Ryz3D/SPEAR/step2/spear74.pdf

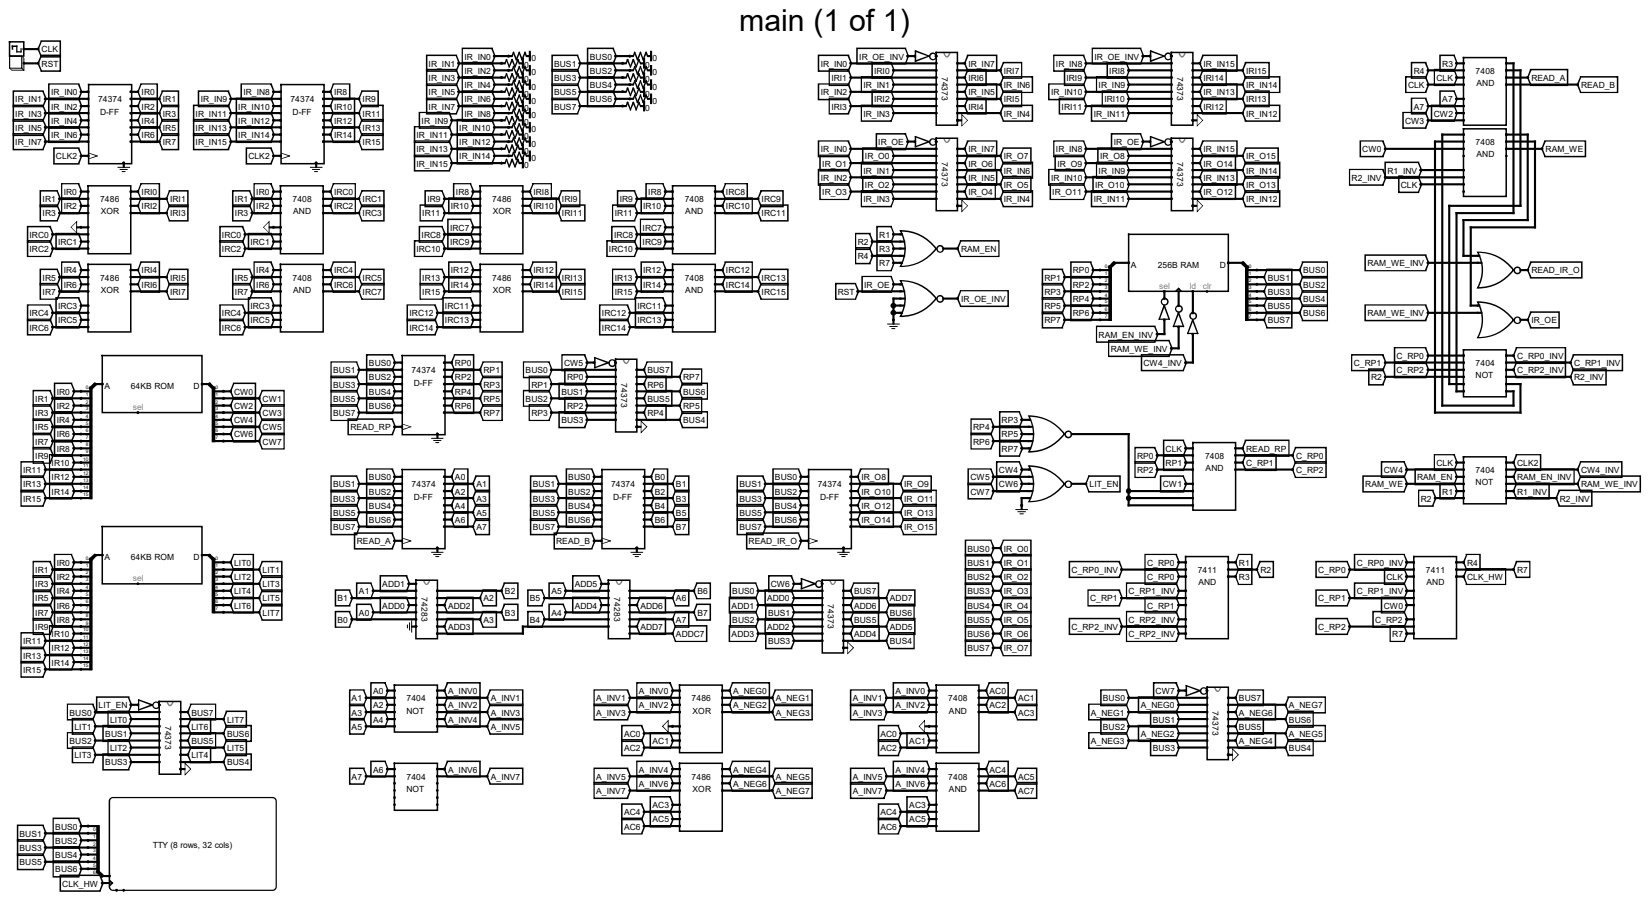
[picture p2: page 1]
main (1 of 1); LIT_EN IR1; R1 LIT6; IR_O2 XOR 7486; BUS5 IR_IN14; BUS7; BUS0 IRI9; IRI14 IR0; 256B RAM; D sel; ld clr; AND 7411 IR5; A_INV0 CW1 IR_IN12 BUS0 IR7; 0 BUS5 7408 AND; A_NEG0 IR11 LIT4; IRI0AC2 BUS3; IR15 BUS3; 74373 BUS4 CW2 IR_IN10 CW7 A7 CW2 IRC0; R1 IR_IN12 CW6 A_INV2 LIT7; BUS1; IR_O14 RP2 A_INV6; XOR 7486; RAM_EN; CLK2 IR_IN1 IR5; A_NEG4 IR11; IRC3; IR14 BUS6 IR4; BUS4; IRC1; RP1 IRI8 BUS5 IRC14; R2_INV AC0; RP6 7408 AND; A_NEG2 IR_O5 IR13; RP2 BUS2; BUS6 LIT1; RAM_EN_INV BUS3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

74373 IRC4 A7A2 IRC4 IRC6 IR_IN13 LIT1 IRC5 AC5 RP3 XOR RP3 7486 IR_O10 IRC8 IR7 7408 AND IR_O0 IR4 IRC7 IRI10 RP5 B2 RP1 IR15 BUS1 RAM_WE IR_O1 BUS6 CW4_INV BUS6 IR_IN11 RAM_EN C_RP0 IR_IN2 IR_OE IR_IN1 7408 AND A7 IR_IN10 IRI11 LIT0 IR_IN15 READ_RP IRC11 IR_IN11 IRI4 RAM_EN_INV IR_O12 IR6

74373 A2 BUS2 IRI15 D-FF 74374 IRC10 R3 R2_INV NOT 7404 BUS0 IRI8 C_RP2_INV 7408 AND IRC11 BUS7 IRI15 AC7

74373 IR10 IR_IN9 IR_IN13 CLK IR3 CLK IR15 IR_O9 IRC9 TTY (8 rows, 32 cols) R7 A_INV3 IR3
