Ryz3D/SPEAR/step3/schematic.pdf

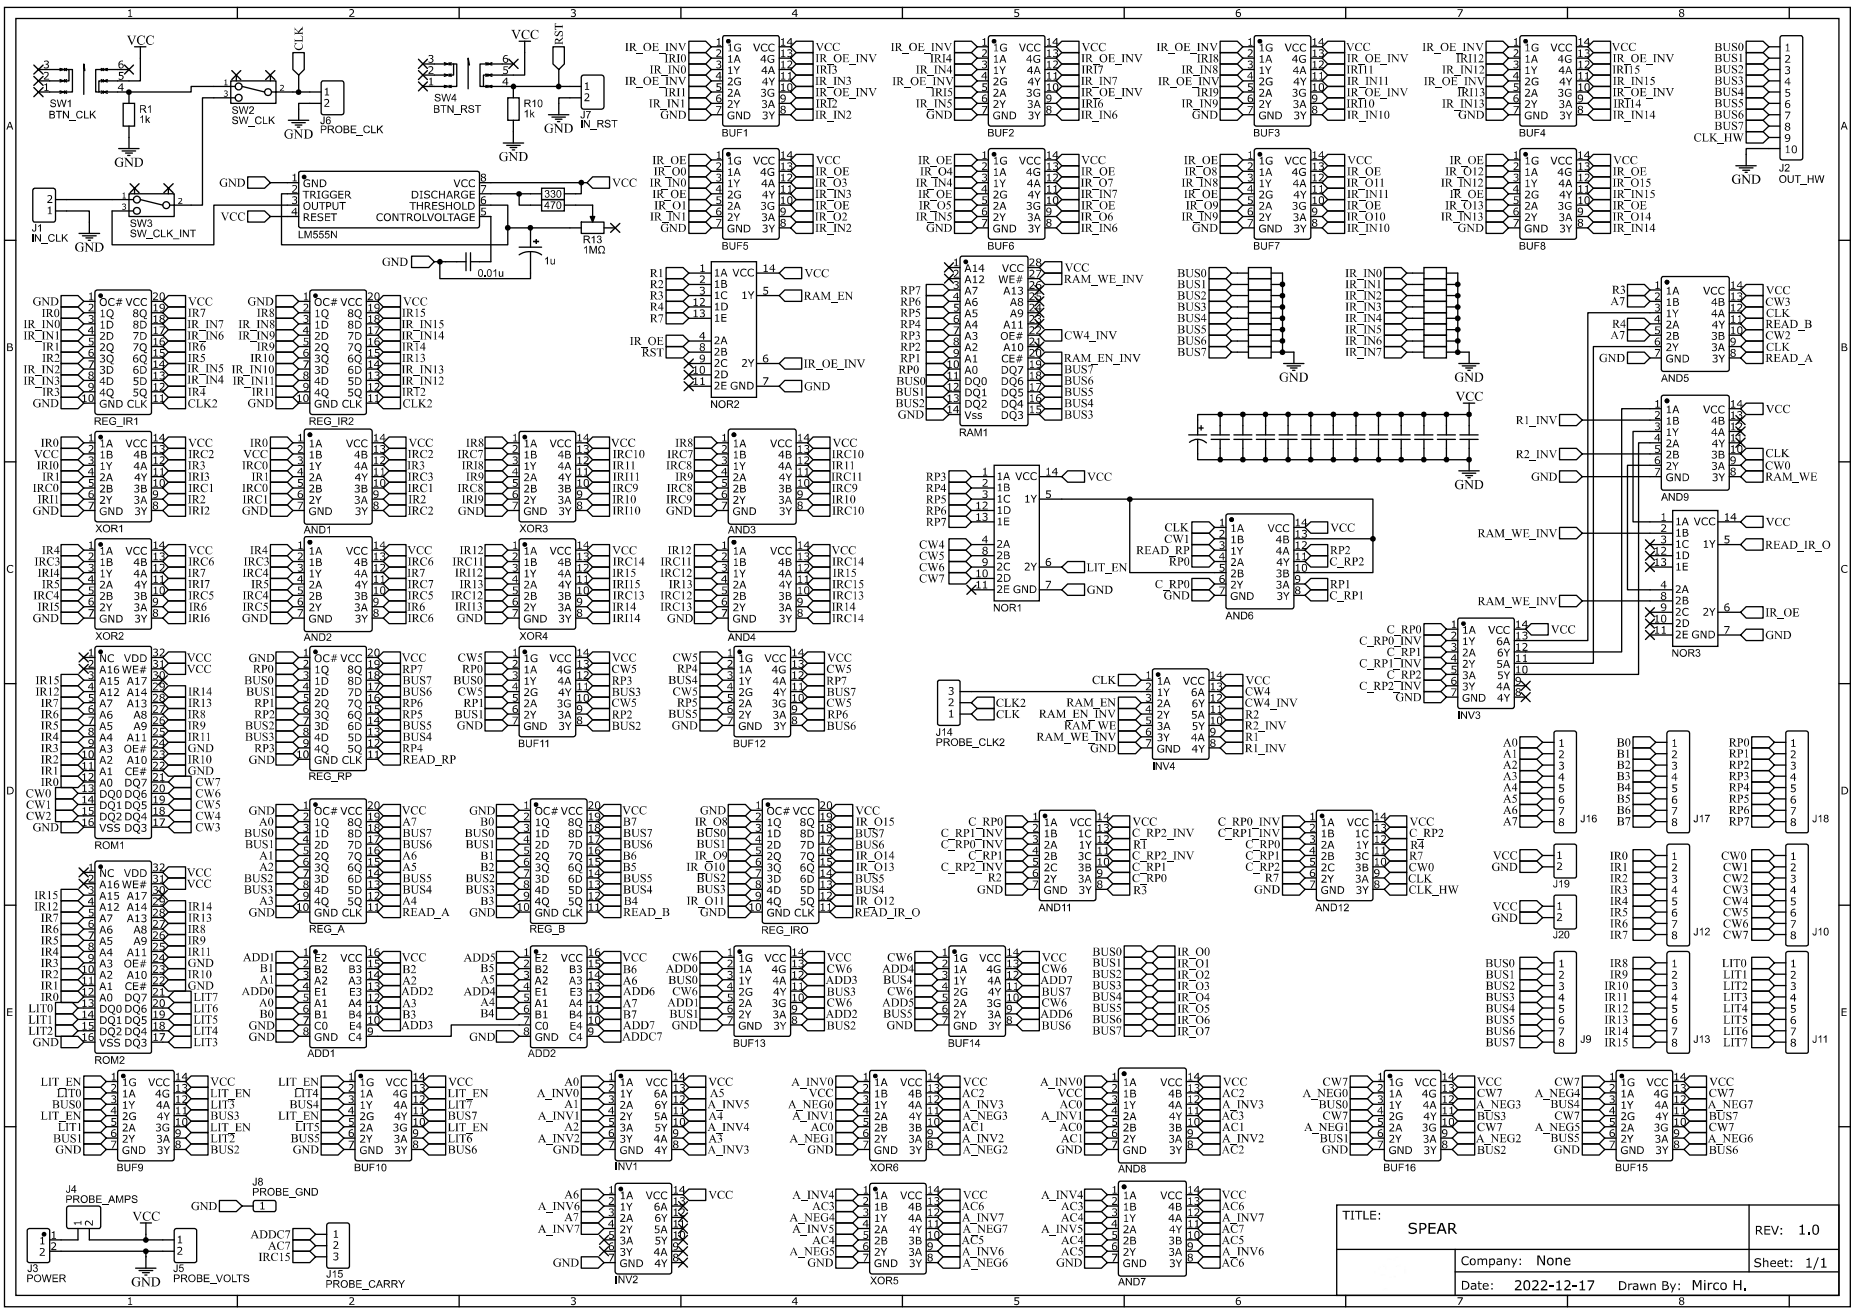
[picture p3: page 1]
