Ryz3D/SPEAR/step1/spear1.pdf

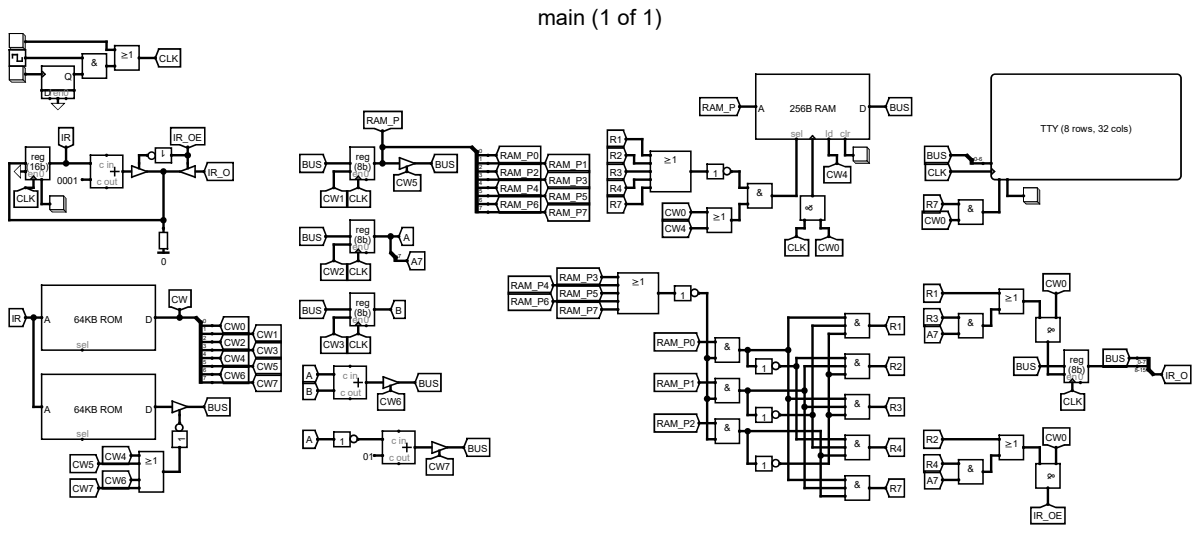
[picture p4: page 1]
main (1 of 1) CW5; BUS R1 & CW6; CLK CW7; 256B RAM; D sel; ld clr A CLK; en0 reg R2; (8b) BUS; RAM_P7 CLK; 1 BUS CW4 IR_OE; c in c outA7; TTY (8 rows, 32 cols) CW2; 1 R3 RAM_P D1en0Q; en0 reg (8b); 1 en0 reg (16b); RAM_P2; 64KB ROM; RAM_P RAM_P0 CW5; & CLK; 1 RAM_P4 CLK CW7; RAM_P5; BUS; RAM_P0 R4; 1 RAM_P4; IR_O BUS; RAM_P3 R7 CW6; RAM_P6; R2 c in c out; CLK A7 c in c out IR; & CLK CW4; 7 BUS CW5; R7 en0 reg (8b); RAM_P1; CW0 R3 BUS; BUS RAM_P1 CW4; 0-6 R4 RAM_P3; & RAM_P7 CW6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
