Ryz3D/SPEAR/(list of files, drawings)

Other design files:
step1/spear1.circ
step2/spear74.circ
step3/easyeda/SCH_SPEAR.json
