Ryz3D/SPEAR/step3/README.md

# Step 3

EasyEDA schematic and PCB design

| IC | Prefix | Quantity |
| --- | --- | --- |
| 555 | 555 | 1 |
| 39SF02070 | ROM | 2 |
| 62256-80 | RAM | 1 |
| 74HC04 | NOT | 4 |
| 74LS08 | AND | 9 |
| 74LS11 | AND | 2 |
| 74LS86 | XOR | 6 |
| 74LS126 | BUF | 16 |
| 74LS260 | NOR | 3 |
| 74LS283 | ADD | 2 |
| 74HC374 | REG | 6 |
| 14-pin socket | | 40 |
| 16-pin socket | | 2 |
| 20-pin socket | | 6 |
| wide 28-pin socket | | 1 |
| wide 32-pin socket | | 2 |

Extra components:
| Component | Quantity |
|---|---|
| 1000uF Capacitor | 1 |
| 100nF 0603 Capacitor | 52 |
| Switch (C136720) | 2 |
| Button (C318861) | 2 |
| Potentiometer (C118945) | 1 |
