Ryz3D/SPEAR/step1/README.md

# Step 1

Simple Logisim implementation using multi-bit connections and default logic gates
