Ryz3D/SPEAR/step2/README.md

# Step 2

Logisim implementation using 1-bit-tunnels and [74 series logic gates](https://github.com/r0the/logi7400)

| Actual IC | Replacement IC for Logisim |
| --- | --- |
| 74xx126 | 74xx574 |
| 74xx260 | Logisim NOR |
